ksinuss/Moscow-Pre-Professional-Olympiad-2023-24/Фотографии устройства/нижняя рейка.jpg

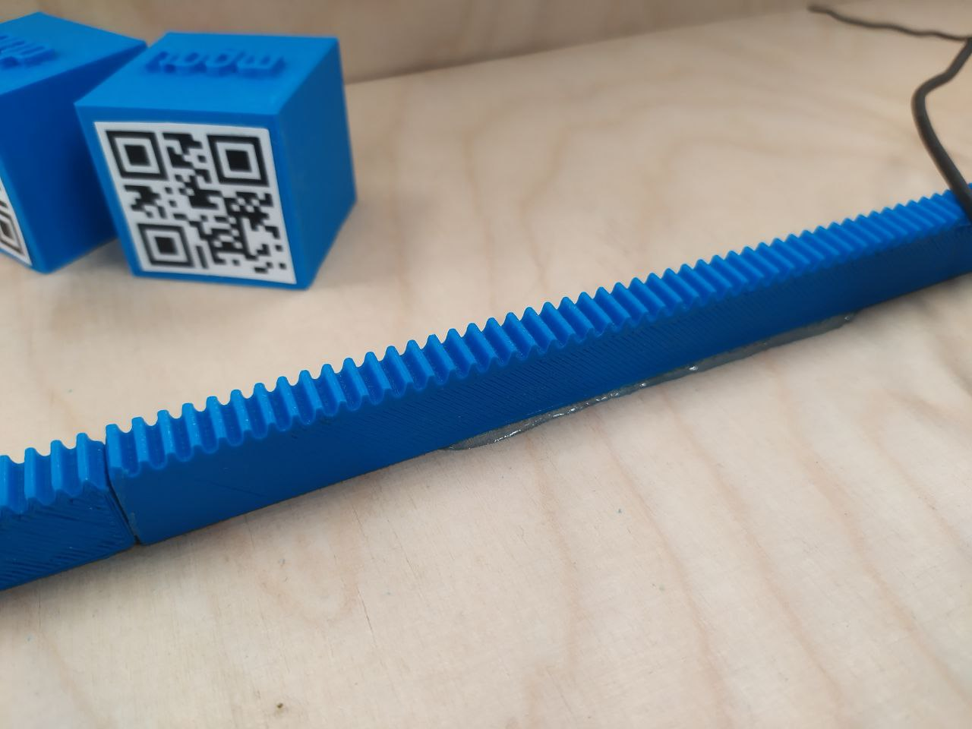
Фотографии устройства/нижняя рейка.jpg
