ksinuss/Moscow-Pre-Professional-Olympiad-2023-24/Фотографии устройства/внутреннее колесо.jpg

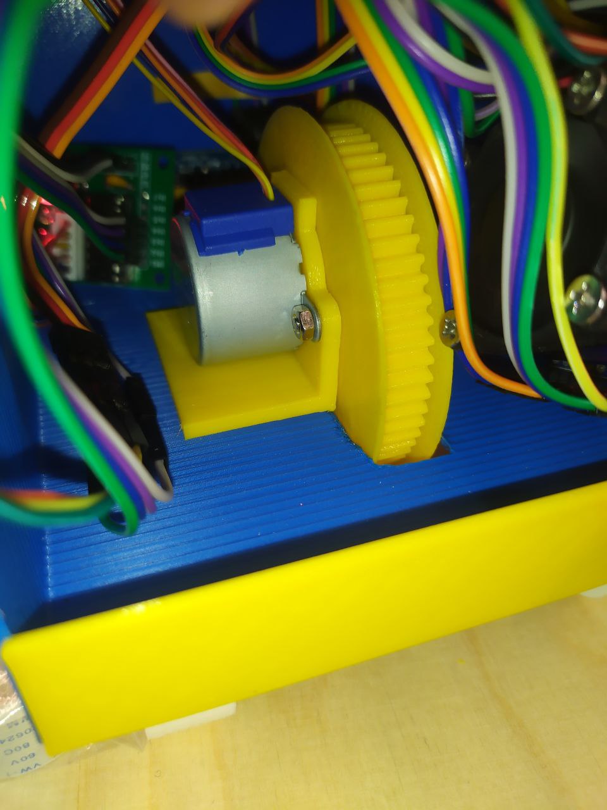
Фотографии устройства/внутреннее колесо.jpg
