ksinuss/Moscow-Pre-Professional-Olympiad-2023-24/docs/HARDWARE.md

# Аппаратное обеспечение проекта

Полный перечень компонентов, использованных для сборки роботизированного сборщика заказов. Проект собран на основе доступного и популярного железа, что подчеркивает его потенциальную рентабельность и повторяемость.

## Сводная таблица компонентов

| Компонент | Модель | Количество | Назначение |
| --- | --- | --- | --- |
| **Одноплатный компьютер** | Raspberry Pi 3 Model B+ | 1 | Мозг системы: распознавание QR-кодов, управление |
| **Микроконтроллер** | Arduino Uno R3 | 2 | Управление моторами, сервоприводами, датчиками |
| **Камера** | Raspberry Pi Camera Module V1 | 1 | Захват изображения QR-кодов |
| **Шаговый двигатель** | 28BYJ-48 + драйвер ULN2003 | 3 | Перемещение каретки и манипулятора |
| **Сервопривод** | FS5113R | 1 | Управление захватом груза |
| **УЗ-датчик расстояния** | HC-SR04 | 3 | Точное позиционирование каретки и манипулятора |
| **Дисплей** | OLED 0.96" (SSD1306) | 1 | Вывод информации о распознанном грузе |
| **Светодиодная лента** | 12V LED Strip | 1 | Подсветка зоны сканирования |
| **Аккумулятор (Pi/Logic)** | LiPo 3S 11.1V 1300mAh | 1 | Питание Raspberry Pi и Arduino |
| **Аккумулятор (LED)** | 12V | 1 | Питание светодиодной подсветки |
| **Преобразователь напряжения** | DC-DC Step Down (5V/3A) | 1 | Стабилизация напряжения для логики |
| **Материалы корпуса** | Фанера, PLA-пластик | - | Несущая конструкция, шестерни, крепеж |

---

## Проблемы и аппаратные решения

| Проблема | Решение |
| --- | --- |
| **Просадки напряжения при работе моторов** | Разделение цепей питания: логика (5V) и подсветка (12V) запитаны от разных аккумуляторов |
| **Низкая точность позиционирования по шаговикам** | Использование УЗ-датчиков (HC-SR04) для аппаратной коррекции позиции и обнуления ошибки накопления |
| **Сложность фокусировки камеры на близких объектах** | Установка камеры на оптимальной высоте и добавление кольцевой светодиодной подсветки для устранения теней |
