ksinuss/Moscow-Pre-Professional-Olympiad-2023-24/Фотографии устройства/full_device.jpg

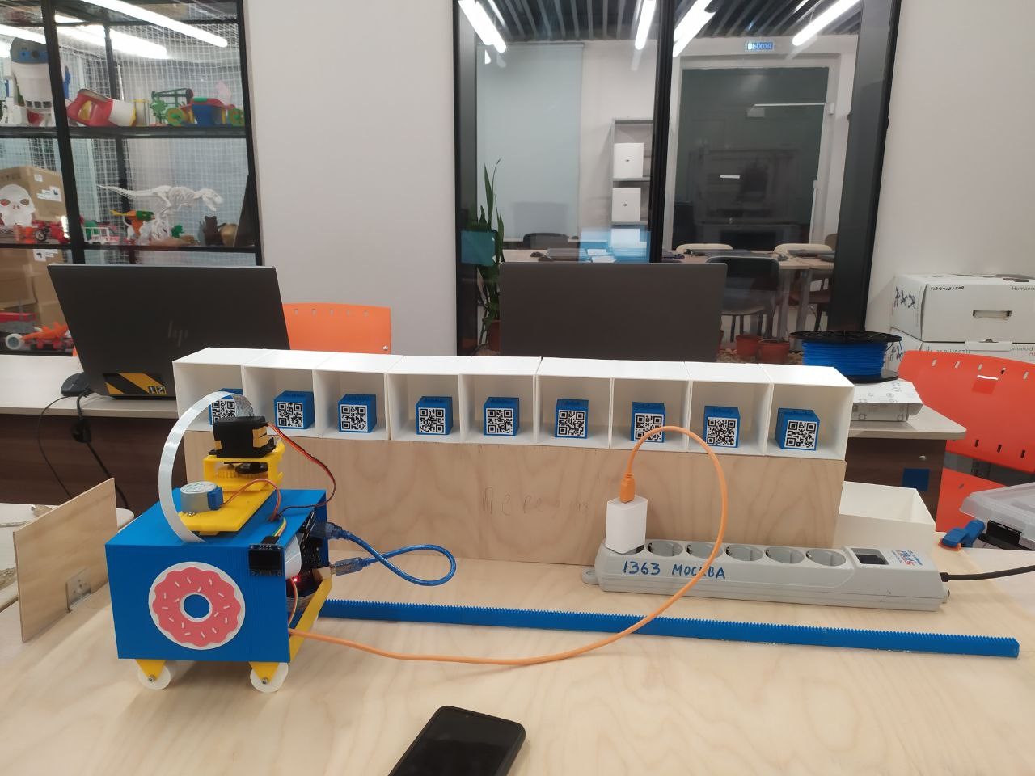
Фотографии устройства/full_device.jpg
