ksinuss/Moscow-Pre-Professional-Olympiad-2023-24/Фотографии устройства/дисплей-груз.jpg

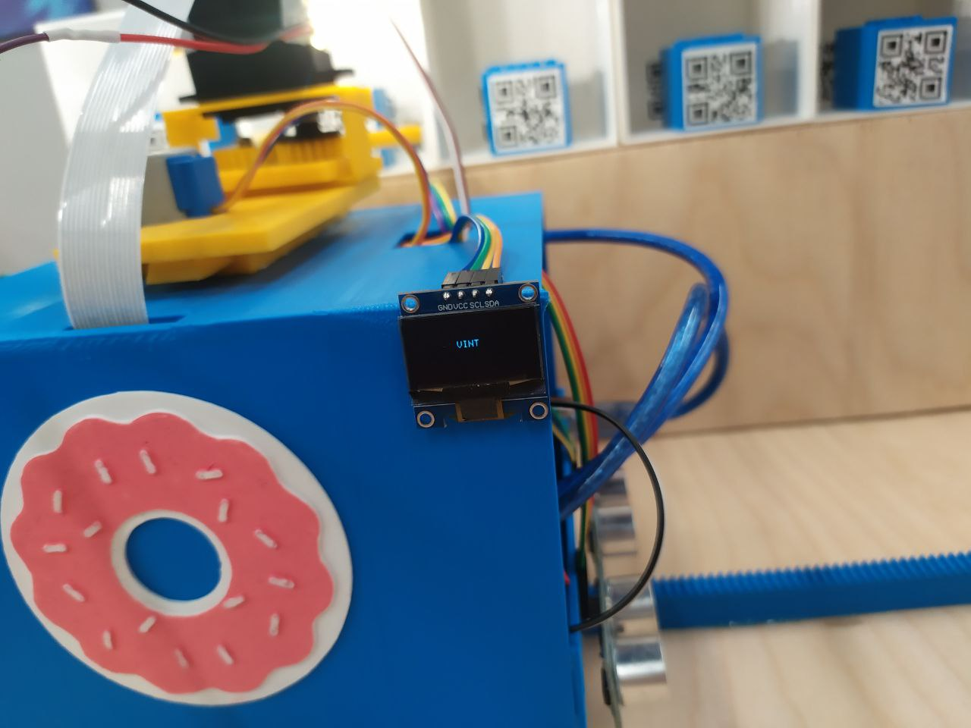
Фотографии устройства/дисплей-груз.jpg
