ksinuss/Moscow-Pre-Professional-Olympiad-2023-24/Фотографии устройства/дисплей-сканирование.jpg

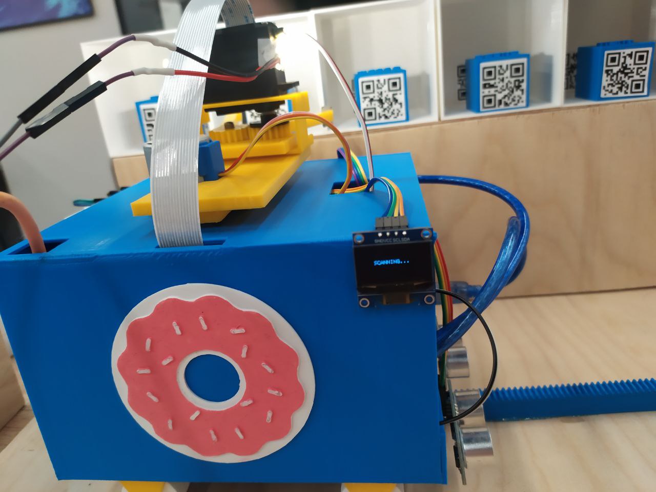
Фотографии устройства/дисплей-сканирование.jpg
