ksinuss/Moscow-Pre-Professional-Olympiad-2023-24/Фотографии устройства/дисплей-финиш.jpg

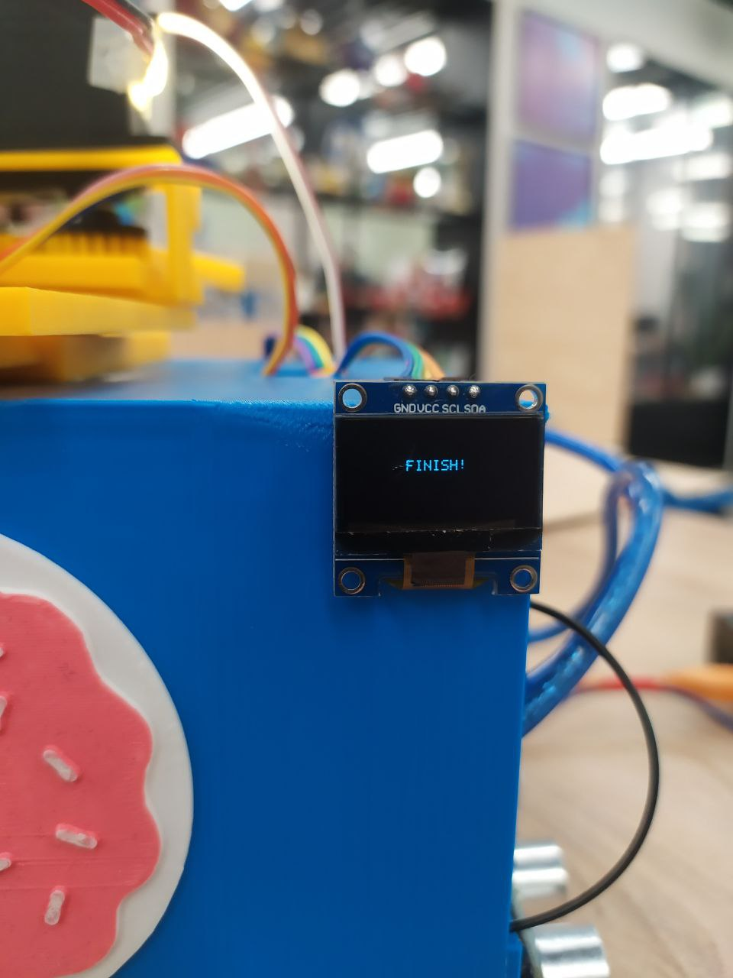
Фотографии устройства/дисплей-финиш.jpg
