ksinuss/Moscow-Pre-Professional-Olympiad-2023-24/Фотографии устройства/затвор.jpg

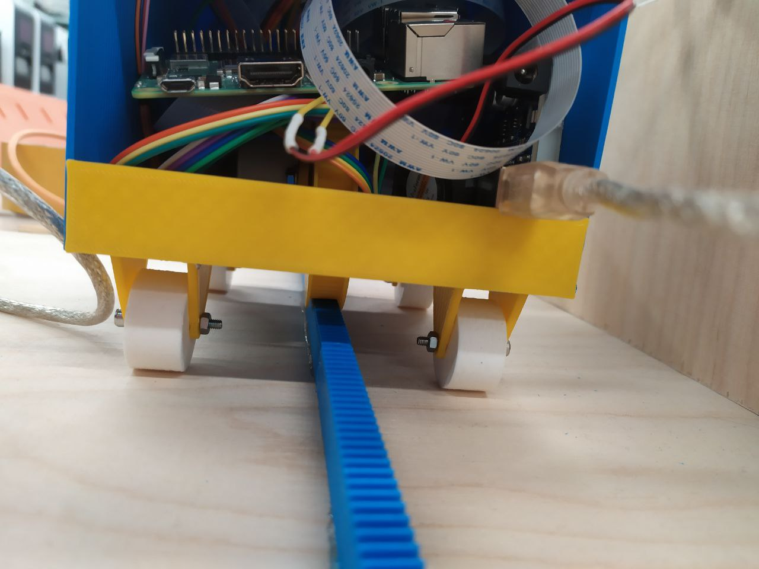
Фотографии устройства/затвор.jpg
