ksinuss/Moscow-Pre-Professional-Olympiad-2023-24/Фотографии устройства/захват.jpg

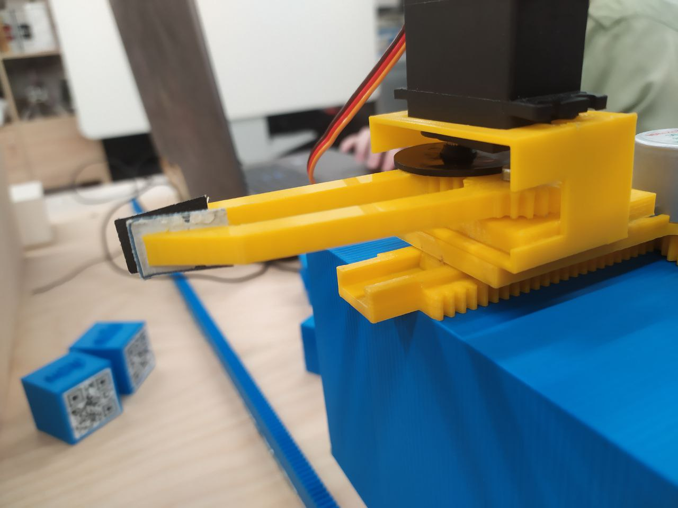
Фотографии устройства/захват.jpg
