ksinuss/Moscow-Pre-Professional-Olympiad-2023-24/Фотографии устройства/камера.jpg

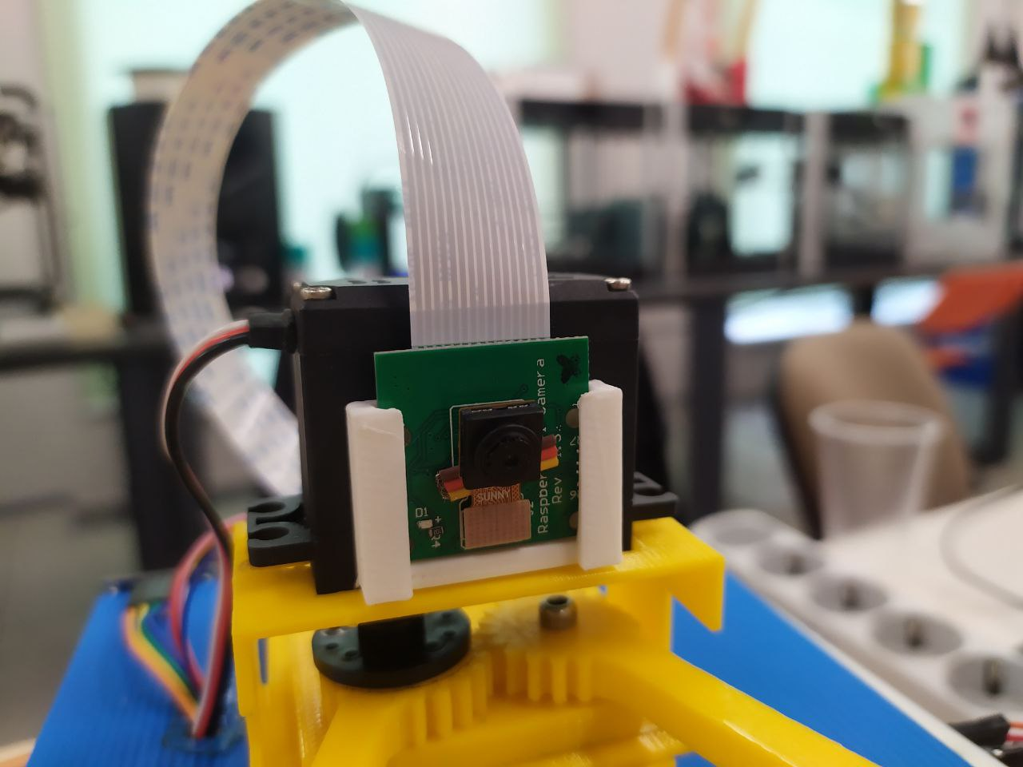
Фотографии устройства/камера.jpg
