ksinuss/Moscow-Pre-Professional-Olympiad-2023-24/Фотографии устройства/колеса.jpg

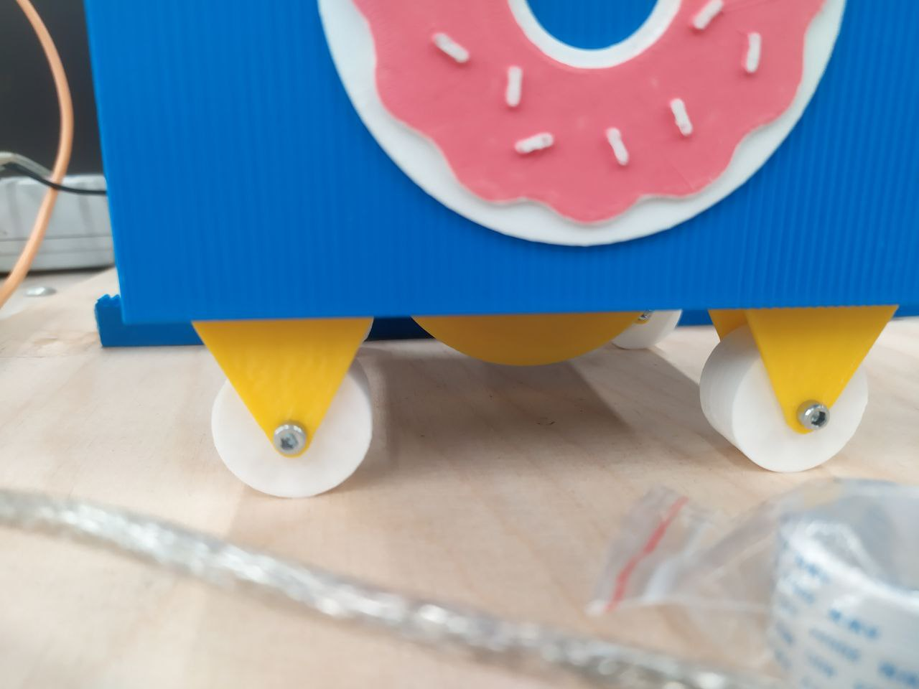
Фотографии устройства/колеса.jpg
