ksinuss/Moscow-Pre-Professional-Olympiad-2023-24/Фотографии устройства/кубики.jpg

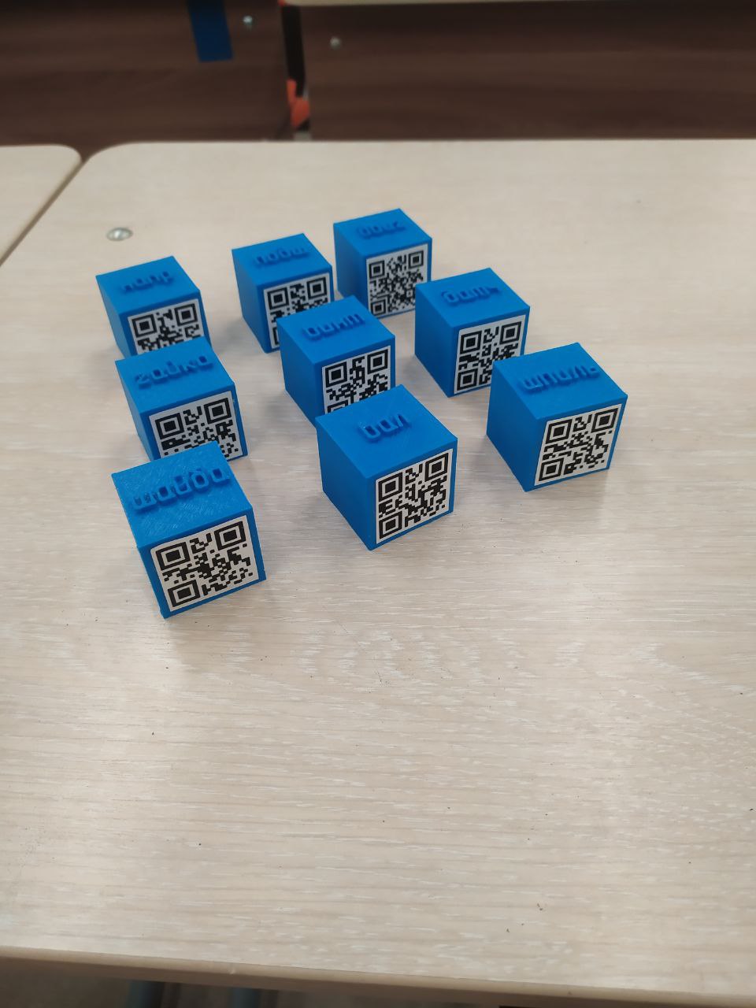
Фотографии устройства/кубики.jpg
