ksinuss/Moscow-Pre-Professional-Olympiad-2023-24/Фотографии устройства/накопитель.jpg

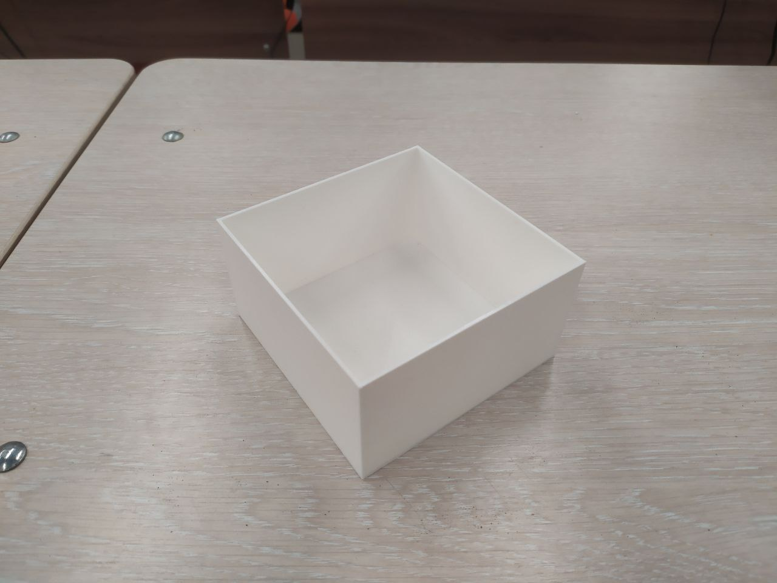
Фотографии устройства/накопитель.jpg
