ksinuss/Moscow-Pre-Professional-Olympiad-2023-24/Фотографии устройства/пончик.jpg

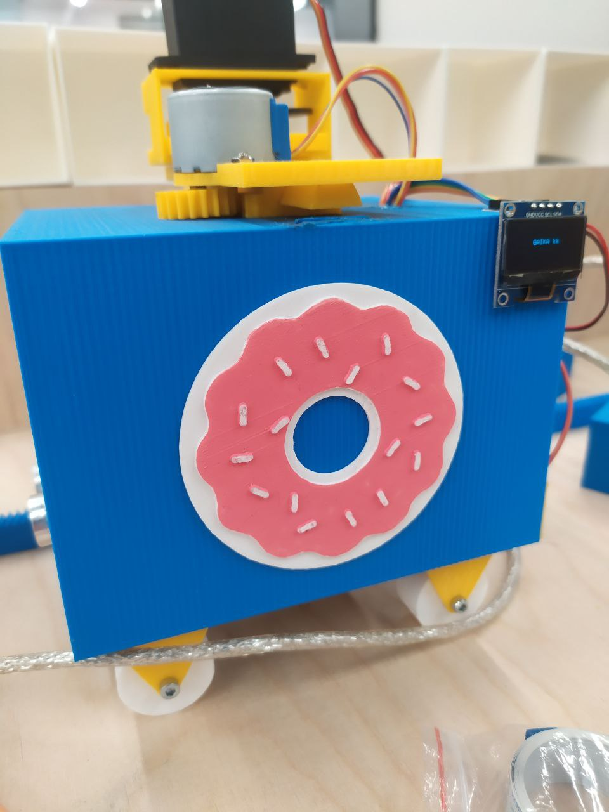
Фотографии устройства/пончик.jpg
