ksinuss/Moscow-Pre-Professional-Olympiad-2023-24/Фотографии устройства/приложение-груз.jpg

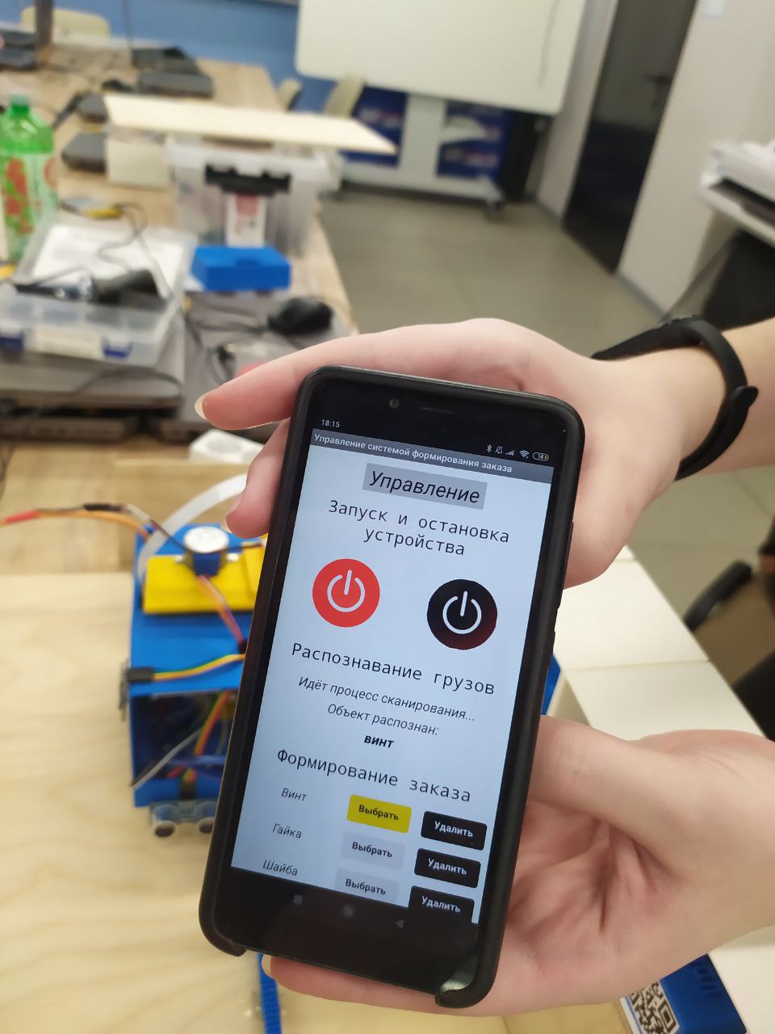
Фотографии устройства/приложение-груз.jpg
