ksinuss/Moscow-Pre-Professional-Olympiad-2023-24/Фотографии устройства/ячейки.jpg

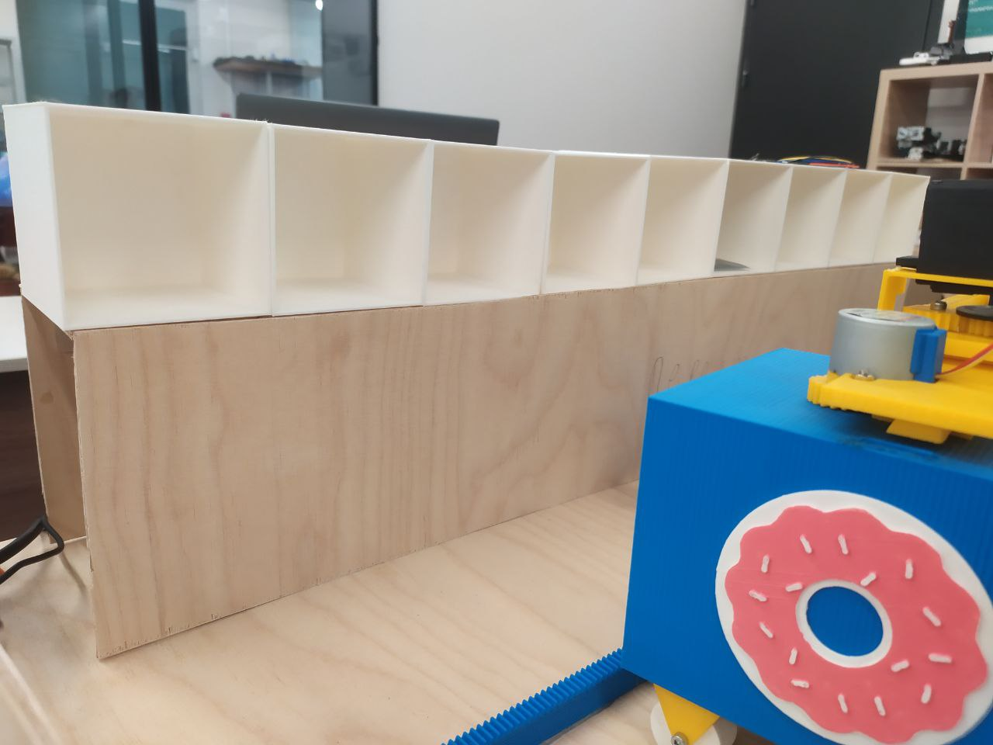
Фотографии устройства/ячейки.jpg
