ksinuss/Moscow-Pre-Professional-Olympiad-2023-24/(commit log)

2024-02-14 Create ее
2024-02-14 work with sensors
2024-02-14 work with servo
2024-02-14 connect arduino
2024-02-21 Create дд
2024-03-31 code for final stage
2025-09-04 add photo of device
2025-09-04 add need libraries for arduino
